hosseinszza/Sidex-release/Software/Test Board/fault.png

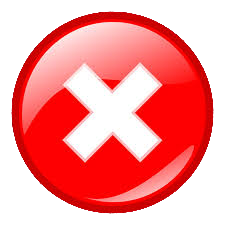
Software/Test Board/fault.png
