hosseinszza/Sidex-release/README.md

# Sidex-release
this files are release of last version
