hosseinszza/Sidex-release/Docs/PM.docx

مدیریت پروژه
چاپ و مونتاژ بردها
مدیریت سخت‌افزاری
پروگرام برد MBS
خدمات سخت‌افزاری پس از فروش
تعریف پروژه جدید در نرم‌افزار
تکمیل برد HBS و EBS
درخواست سیم‌کارت
تست و QC بردها
مدیریت سیم‌کشی پنل‌ها
تست پنل‌ها
خرید تجهیزات نصب
مدیریت نصب پروژه
ارتباط اینترنت بدون اتصال بررسی شود.
قرار دادن برد EBS در تابلو و تست نرم‌افزاری (فقط با اتصال LANها)
سیم‌کشی بردهای EBS در تابلو فرمان
بررسی کارایی EBS (بررسی سون‌سگمنت‌ها و احضارها در نرم‌افزار)
سیم‌کشی طبقات (پاور و LAN طبقات وصل نشود)
نصب پاور و LAN از بالاترین طبقه و بررسی ترتیبی با نرم‌افزار
انجام Learning آسانسور در حالت Noemal
سیم‌کشی شستی داخل کابین
قرار دادن آسانسورها در حالت Ready
تست تمامی پنل‌ها

مراحل راه‌اندازی پروژه
