hosseinszza/Sidex-release/PMF 1402-06-01.xlsx

Sheet: Hub Board
Component | Footprint | Required Amount
RJ45 FMR | RJ45 Female Right | 3
Phoenix 2MR 5.08 | phonix 2pin right 5.08 | 1

Sheet: Touch Board
Component | Footprint | Required Amount
Cap 1000uF(dip) | cap 03 | 1
Cap 100nF(1206) | SMD_CAP_1206 | 1
Cap 100uF(dip) | cap 03 | 1
Cap 10uF(Ctantal) | CAPMP6032X280N | 1
D SM5822 | 1N5822 smd - Size A (SMA) - smd code SS34 | 2
F 4A(1206) | Fuse SMD 1206 | 1
IC ADM485 | SO8_NARROW_N | 1
Ind 100uH(RH127) | BOURNS SRR1280 | 1
LAN Cable(5m) |  | 1
LED Red(603) | LED 0603/1608 RED | 3
Phoenix 2MR 5.08 | phonix 2pin right 5.08 | 1
Phoenix 8MR 3.81 | phonix 8pin right 3.81 | 1
Pin Header Female 20x2 | FEMALE 20x2 | 1
Pin Header Male 2x1 | Male 2X1 | 1
Power Jack | Power Jack | 1
Power Source 24V 2A |  | 1
Rasberry FAN |  | 1
Rasberry Pi4 2GB RAM |  | 1
Reg LM2576-5V | TO-263-5 | 1
Res 10K(603) | RES 0603 (1608X06L) | 2
Res 150R(1206) | RES 1206 (3216X08L) | 1
Res 1K(603) | RES 0603 (1608X06L) | 1
Res 560R(603) | RES 0603 (1608X06L) | 2
RJ45 FMR | RJ45 Female Right | 1
SD Card(16GB) |  | 1

Sheet: HBS V1.0
Component | Footprint | Required Amount
Cap 100nF(1206) | SMD_CAP_1206 | 2
Cap 100nF(603) | SMD_CAP_0603 | 1
Cap 100uF(dip) | cap 03 | 1
Cap 100uF(Ctantal) | CAPMP6032X280N | 3
Cap 10pF(603) | SMD_CAP_0603 | 2
Cap 10uF(603) | SMD_CAP_0603 | 24
Cap 10uF(Atantal) | CAPMP3216X180N | 1
Cap 1uF(603) | SMD_CAP_0603 | 1
Cap 20pF(603) | SMD_CAP_0603 | 2
Cap 2200uF(dip) | cap 03 | 1
Cap 330nF(1206) | 1206 | 1
D SM5822 | 1N5822 smd - Size A (SMA) - smd code SS34 | 3
D LL4148 | 1N4148 smd | 2
D SM712 | SOT23_BEC_M | 1
DZ 3.6V(Minimelf) | Minimelf | 10
DZ 30V(Minimelf) | Minimelf | 24
DZ 5.6V(Minimelf) | Minimelf | 1
DZ 9.1V(Minimelf) | Minimelf | 1
F 1A(1206) | Fuse SMD 1206 | 1
IC 74HC165 | SO-16 | 4
IC 74HC595 | SO-16 | 5
IC ADM485 | SO8_NARROW_N | 1
IC STM32F103C8T6 | LQFP-48 | 1
Ind 100uH(CD54) | CD45 SMD Inductor | 1
Ind 22uH(HPC6045) | HPC6045 or CD54 SMD INDUCTOR | 1
Jumper | Don't Forger Header 2x1 | 1
LAN Cable(5m) |  | 2
LED Red(1206) | LED SMD 1206 | 3
LED Red(603) | LED 0603/1608 RED | 42
Pair of Wires(10m) |  | 1
Phoenix 10MR 3.81 | phonix 10pin right 3.81 | 2
Phoenix 2MR 5.08 | phonix 2pin right 5.08 | 1
Phoenix 4MR 3.81 | phonix 4pin right 3.81 | 3
Phoenix 8MR 3.81 | phonix 8pin right 3.81 | 1
Pin Header Male Right 1x4 | Header 1x4 male rightangle | 1
Push Button | TE FSMSMTR | 1
Reg AMS1117-3.3 | SOT223 | 1
Reg L7805 | D2PAK-3 | 1
Reg LM2576-Adj | TO-263-5 | 1
Res 1.5K(603) | RES 0603 (1608X06L) | 1
Res 100K(1206) | RES 1206 (3216X08L) | 24
Res 10K(603) | RES 0603 (1608X06L) | 19
Res 10K(805) | RES 0805 (2012X06L) | 24
Res 150R(1206) | RES 1206 (3216X08L) | 1
Res 1K(1206) | RES 1206 (3216X08L) | 40
Res 1K(603) | RES 0603 (1608X06L) | 1
Res 1K(805) | RES 0805 (2012X06L) | 1
Res 20R(1206) | RES 1206 (3216X08L) | 40
Res 20R(603) | RES 0603 (1608X06L) | 4
Res 390R(603) | RES 0603 (1608X06L) | 1
Res 4.7K(805) | RES 0805 (2012X06L) | 1
Res 560R(603) | RES 0603 (1608X06L) | 3
Res 5K(1206) | RES 1206 (3216X08L) | 40
Res 5K(603) | RES 0603 (1608X06L) | 1
RFID RC522 Module |  | 1
RJ45 FMR | RJ45 Female Right | 1
SW DIP-2 | DIP Switch x2 | 1
SW DIP-6 | DIP Switch x6 | 1
Tr BSS138 | SOT23-3 | 24
Tr BC848 | SOT23-3 | 40
USB Micro | FCI USB 10118193-0001LF | 1
Var 07D471K | Varistor Short Hieght - Vertical | 2
XH 8FMR | Wired | 1
XH 8MR | CN_JST-B8B-S_XH | 1
XTAL 32.768KHz | XTAL RTC - Right | 1
XTAL 8MHz | Crystal SMD | 1
Print Board HBS V1.0 |  | 1
Assemble Board HBS V1.0 |  | 1

Sheet: HBS V2
Component | Footprint | Required Amount
Cap 100nF(1206) | SMD_CAP_1206 | 3
Cap 100nF(603) | SMD_CAP_0603 | 1
Cap 100uF(dip) | cap 03 | 1
Cap 100uF(Ctantal) | CAPMP6032X280N | 3
Cap 10pF(603) | SMD_CAP_0603 | 2
Cap 10uF(603) | SMD_CAP_0603 | 20
Cap 10uF(Atantal) | CAPMP3216X180N | 2
Cap 1uF(603) | SMD_CAP_0603 | 1
Cap 20pF(603) | SMD_CAP_0603 | 2
Cap 2200uF(dip) | cap 03 | 1
Cap 1nF(603) | SMD_CAP_0603 | 1
Cap 330nF(1206) | 1206 | 1
D SM5822 | 1N5822 smd - Size A (SMA) - smd code SS34 | 3
D LL4148 | 1N4148 smd | 22
D SM712 | SOT23_BEC_M | 2
DZ 3.6V(Minimelf) | Minimelf | 10
DZ 5.6V(Minimelf) | Minimelf | 1
DZ 9.1V(Minimelf) | Minimelf | 1
F 1A(1206) | Fuse SMD 1206 | 1
IC 74HC165 | SO-16 | 4
IC 74HC595 | SO-16 | 4
IC ADM485 | SO8_NARROW_N | 2
IC STM32F103C8T6 | LQFP-48 | 1
Ind 100uH(CD54) | CD45 SMD Inductor | 1
Ind 22uH(HPC6045) | HPC6045 or CD54 SMD INDUCTOR | 1
Jumper | Don't Forger Header 2x1 | 2
LAN Cable(5m) |  | 2
LED Red(1206) | LED SMD 1206 | 3
LED Red(603) | LED 0603/1608 RED | 26
Pair of Wires(10m) |  | 1
Phoenix 2MR 5.08 | phonix 2pin right 5.08 | 2
Phoenix 4MR 3.81 | phonix 4pin right 3.81 | 2
Phoenix 8MR 3.81 | phonix 8pin right 3.81 | 2
Pin Header Male Right 1x4 | Header 1x4 male rightangle | 1
Push Button | TE FSMSMTR | 1
Reg AMS1117-3.3 | SOT223 | 1
Reg L7805 | D2PAK-3 | 1
Reg LM2576-Adj | TO-263-5 | 1
Res 1.5K(603) | RES 0603 (1608X06L) | 1
Res 10K(603) | RES 0603 (1608X06L) | 24
Res 10K(805) | RES 0805 (2012X06L) | 20
Res 150R(1206) | RES 1206 (3216X08L) | 1
Res 1K(1206) | RES 1206 (3216X08L) | 24
Res 1K(603) | RES 0603 (1608X06L) | 1
Res 1K(805) | RES 0805 (2012X06L) | 1
Res 20R(1206) | RES 1206 (3216X08L) | 24
Res 20R(603) | RES 0603 (1608X06L) | 6
Res 390R(603) | RES 0603 (1608X06L) | 1
Res 4.7K(603) | RES 0603 (1608X06L) | 1
Res 4.7K(805) | RES 0805 (2012X06L) | 1
Res 560R(603) | RES 0603 (1608X06L) | 3
Res 5.6K(0805) | RES 0805 (2012X06L) | 1
Res 5K(1206) | RES 1206 (3216X08L) | 24
Res 5K(603) | RES 0603 (1608X06L) | 1
Res 100K(603) | RES 0603 (1608X06L) | 20
RFID RC522 Module |  | 1
RJ45 FMR | RJ45 Female Right | 2
SW DIP-2 | DIP Switch x2 | 1
SW DIP-6 | DIP Switch x6 | 1
Tr BSS138 | SOT23-3 | 20
Tr BC848 | SOT23-3 | 24
USB Micro | FCI USB 10118193-0001LF | 1
Var 07D471K | Varistor Short Hieght - Vertical | 2
XH 8FMR | Wired | 1
XH 8MR | CN_JST-B8B-S_XH | 1
XH 5FMR | Wired | 1
XH 5MR | CN_JST-B5B-S_XH | 1
XTAL 32.768KHz | XTAL RTC - Right | 1
XTAL 8MHz | Crystal SMD | 1
Print Board HBS V2.0 |  | 1
Assemble Board HBS V2.0 |  | 1

Sheet: HBS Screen
Component | Footprint | Required Amount
Cap 100nF(1206) | SMD_CAP_1206 | 3
Cap 100nF(603) | SMD_CAP_0603 | 1
Cap 100uF(dip) | cap 03 | 1
Cap 100uF(Ctantal) | CAPMP6032X280N | 3
Cap 10pF(603) | SMD_CAP_0603 | 2
Cap 10uF(603) | SMD_CAP_0603 | 20
Cap 10uF(Atantal) | CAPMP3216X180N | 2
Cap 1uF(603) | SMD_CAP_0603 | 1
Cap 20pF(603) | SMD_CAP_0603 | 2
Cap 2200uF(dip) | cap 03 | 1
Cap 1nF(603) | SMD_CAP_0603 | 1
Cap 330nF(1206) | 1206 | 1
D SM5822 | 1N5822 smd - Size A (SMA) - smd code SS34 | 3
D LL4148 | 1N4148 smd | 22
D SM712 | SOT23_BEC_M | 2
DZ 3.6V(Minimelf) | Minimelf | 10
DZ 5.6V(Minimelf) | Minimelf | 1
DZ 9.1V(Minimelf) | Minimelf | 1
F 1A(1206) | Fuse SMD 1206 | 1
IC 74HC165 | SO-16 | 4
IC 74HC595 | SO-16 | 4
IC ADM485 | SO8_NARROW_N | 2
IC STM32F103C8T6 | LQFP-48 | 1
Ind 100uH(CD54) | CD45 SMD Inductor | 1
Ind 22uH(HPC6045) | HPC6045 or CD54 SMD INDUCTOR | 1
Jumper | Don't Forger Header 2x1 | 2
LAN Cable(5m) |  | 2
LED Red(1206) | LED SMD 1206 | 3
LED Red(603) | LED 0603/1608 RED | 26
Pair of Wires(10m) |  | 1
Phoenix 2MR 5.08 | phonix 2pin right 5.08 | 2
Phoenix 4MR 3.81 | phonix 4pin right 3.81 | 2
Phoenix 8MR 3.81 | phonix 8pin right 3.81 | 2
Pin Header Male Right 1x4 | Header 1x4 male rightangle | 1
Push Button | TE FSMSMTR | 1
Reg AMS1117-3.3 | SOT223 | 1
Reg L7805 | D2PAK-3 | 1
Reg LM2576-Adj | TO-263-5 | 1
Res 1.5K(603) | RES 0603 (1608X06L) | 1
Res 10K(603) | RES 0603 (1608X06L) | 24
Res 10K(805) | RES 0805 (2012X06L) | 20
Res 150R(1206) | RES 1206 (3216X08L) | 1
Res 1K(1206) | RES 1206 (3216X08L) | 24
Res 1K(603) | RES 0603 (1608X06L) | 1
Res 1K(805) | RES 0805 (2012X06L) | 1
Res 20R(1206) | RES 1206 (3216X08L) | 24
Res 20R(603) | RES 0603 (1608X06L) | 6
Res 390R(603) | RES 0603 (1608X06L) | 1
Res 4.7K(603) | RES 0603 (1608X06L) | 1
Res 4.7K(805) | RES 0805 (2012X06L) | 1
Res 560R(603) | RES 0603 (1608X06L) | 3
Res 5.6K(0805) | RES 0805 (2012X06L) | 1
Res 5K(1206) | RES 1206 (3216X08L) | 24
Res 5K(603) | RES 0603 (1608X06L) | 1
Res 100K(603) | RES 0603 (1608X06L) | 20
RFID RC522 Module |  | 1
RJ45 FMR | RJ45 Female Right | 2
SW DIP-2 | DIP Switch x2 | 1
SW DIP-6 | DIP Switch x6 | 1
Tr BSS138 | SOT23-3 | 20
Tr BC848 | SOT23-3 | 24
USB Micro | FCI USB 10118193-0001LF | 1
Var 07D471K | Varistor Short Hieght - Vertical | 2
XH 8FMR | Wired | 1
XH 8MR | CN_JST-B8B-S_XH | 1
XH 5FMR | Wired | 1
XH 5MR | CN_JST-B5B-S_XH | 1
XTAL 32.768KHz | XTAL RTC - Right | 1
XTAL 8MHz | Crystal SMD | 1

Sheet: EBS V1.0
Component | Footprint | Required Amount
Cap 100nF(1206) | 1206 | 2
Cap 100nF(603) | SMD_CAP_0603 | 1
Cap 100uF(Ctantal) | CAPMP6032X280N | 2
Cap 10pF(603) | SMD_CAP_0603 | 1
Cap 10uF(603) | SMD_CAP_0603 | 24
Cap 10uF(Atantal) | CAPMP3216X180N | 1
Cap 1uF(603) | SMD_CAP_0603 | 19
Cap 20pF(603) | SMD_CAP_0603 | 2
Cap 330nF(1206) | 1206 | 1
D SM5822 | 1N5822 smd - Size A (SMA) - smd code SS34 | 2
D LL4148 | 1N4148 smd | 27
D SM712 | SOT23_BEC_M | 1
DZ 3.6V(Minimelf) | Minimelf | 4
DZ 5.6V(Minimelf) | Minimelf | 1
DZ 9.1V(Minimelf) | Minimelf | 1
F 1A(1206) | Fuse SMD 1206 | 2
FB BLM21PG | R 0805 / 2012 | 1
IC 74HC165 | SO-16 | 5
IC 74HC595 | SO-16 | 3
IC ADM485 | SO8_NARROW_N | 1
IC STM32F103C8T6 | LQFP-48 | 1
IC ULN2003 | SO-16 | 1
LAN Cable(5m) |  | 1
LED Green(1206) | LED SMD 1206 | 1
LED Red(1206) | LED SMD 1206 | 3
LED Red(603) | LED 0603/1608 RED | 42
Opto PC814 | PS2501-1 | 1
Opto TLP521 | PS2501-1 | 16
Phoenix 10MR 3.81 | phonix 10pin right 3.81 | 2
Phoenix 2MR 5.08 | phonix 2pin right 5.08 | 1
Phoenix 4MR 3.81 | phonix 4pin right 3.81 | 1
Phoenix 8MR 3.81 | phonix 8pin right 3.81 | 2
Pin Header Male Right 1x4 | Header 1x4 male rightangle | 1
Push Button | TE FSMSMTR | 1
Reg AMS1117-3.3 | SOT223 | 1
Reg L7805 | D2PAK-3 | 1
Relay 5V 7A | Relay 20x16x20 HJR | 1
Res 1.5K(603) | RES 0603 (1608X06L) | 1
Res 100K(603) | RES 0603 (1608X06L) | 24
Res 10K(603) | RES 0603 (1608X06L) | 14
Res 10K(805) | RES 0805 (2012X06L) | 24
Res 150R(1206) | RES 1206 (3216X08L) | 1
Res 180K(1206) | RES 1206 (3216X08L) | 1
Res 1K(1206) | RES 1206 (3216X08L) | 24
Res 1K(603) | RES 0603 (1608X06L) | 1
Res 3.6K(1206) | RES 1206 (3216X08L) | 16
Res 20K(603) | RES 0603 (1608X06L) | 17
Res 20R(603) | RES 0603 (1608X06L) | 4
Res 390R(603) | RES 0603 (1608X06L) | 1
Res 560R(603) | RES 0603 (1608X06L) | 4
Res 5K(1206) | RES 1206 (3216X08L) | 16
Res 5K(603) | RES 0603 (1608X06L) | 25
RJ45 FMR | RJ45 Female Right | 1
SW DIP-4 | DIP Switch x4 | 1
Tr BSS138 | SOT23-3 | 24
Tr BC848 | SOT23-3 | 24
USB Micro | FCI USB 10118193-0001LF | 1
Var 07D471K | Varistor Short Hieght - Vertical | 2
XH 4FMR | Wired | 1
XH 4MR | CN_JST-B4B-S_XH | 1
XTAL 32.768KHz | XTAL RTC - Right | 1
XTAL 8MHz | Crystal SMD | 1
Print Board EBS V1.0 |  | 1
Assemble Board EBS V1.0 |  | 1

Sheet: EBS V2
Component | Footprint | Required Amount
Cap 100uF(dip) | cap 03 | 2
Cap 2200uF(dip) | cap 03 | 1
Cap 1000uF(dip) | cap 03 | 1
Cap 100nF(1206) | 1206 | 3
Cap 100nF(603) | SMD_CAP_0603 | 1
Cap 100uF(Ctantal) | CAPMP6032X280N | 3
Cap 10pF(603) | SMD_CAP_0603 | 1
Cap 10uF(Atantal) | CAPMP3216X180N | 2
Cap 1uF(603) | SMD_CAP_0603 | 15
Cap 20pF(603) | SMD_CAP_0603 | 2
Cap 1nF(603) | SMD_CAP_0603 | 1
Cap 330nF(1206) | 1206 | 1
D SM5822 | 1N5822 smd - Size A (SMA) - smd code SS34 | 3
D LL4148 | 1N4148 smd | 3
D SM712 | SOT23_BEC_M | 2
DZ 3.6V(Minimelf) | Minimelf | 4
DZ 5.6V(Minimelf) | Minimelf | 1
DZ 9.1V(Minimelf) | Minimelf | 1
DZ 13V(Minimelf) | Minimelf | 1
F 1A(1206) | Fuse SMD 1206 | 3
FB BLM21PG | R 0805 / 2012 | 1
Jumper | Don't Forger Header 2x1 | 3
IC 74HC165 | SO-16 | 2
IC ADM485 | SO8_NARROW_N | 2
IC STM32F103C8T6 | LQFP-48 | 1
IC ULN2003 | SO-16 | 1
Ind 100uH(CD54) | CD45 SMD Inductor | 2
Ind 22uH(HPC6045) | HPC6045 or CD54 SMD INDUCTOR | 1
LAN Cable(5m) |  | 1
LED Green(1206) | LED SMD 1206 | 1
LED Red(1206) | LED SMD 1206 | 3
LED Red(603) | LED 0603/1608 RED | 14
Opto PC814 | PS2501-1 | 1
Opto TLP521 | PS2501-1 | 12
Phoenix 2MR 5.08 | phonix 2pin right 5.08 | 1
Phoenix 4MR 3.81 | phonix 4pin right 3.81 | 2
Phoenix 8MR 3.81 | phonix 8pin right 3.81 | 1
Pin Header Male Right 1x4 | Header 1x4 male rightangle | 1
Push Button | TE FSMSMTR | 1
Reg AMS1117-3.3 | SOT223 | 1
Reg L7805 | D2PAK-3 | 1
Reg LM2576-Adj | TO-263-5 | 1
Reg LM2576-12V | TO-263-5 | 1
Relay 5V 7A | Relay 20x16x20 HJR | 1
Res 1.5K(603) | RES 0603 (1608X06L) | 1
Res 10K(603) | RES 0603 (1608X06L) | 19
Res 150R(1206) | RES 1206 (3216X08L) | 2
Res 180K(1206) | RES 1206 (3216X08L) | 1
Res 1K(603) | RES 0603 (1608X06L) | 1
Res 3.6K(1206) | RES 1206 (3216X08L) | 12
Res 20K(603) | RES 0603 (1608X06L) | 13
Res 20R(603) | RES 0603 (1608X06L) | 6
Res 390R(603) | RES 0603 (1608X06L) | 1
Res 560R(603) | RES 0603 (1608X06L) | 4
Res 5K(1206) | RES 1206 (3216X08L) | 12
Res 5K(603) | RES 0603 (1608X06L) | 1
Res 47K(603) | RES 0603 (1608X06L) | 1
Res 4.7K(805) |  | 1
Res 1K(805) |  | 1
RJ45 FMR | RJ45 Female Right | 2
SW DIP-4 | DIP Switch x4 | 1
USB Micro | FCI USB 10118193-0001LF | 1
Var 07D471K | Varistor Short Hieght - Vertical | 4
XH 4FMR | Wired | 1
XH 4MR | CN_JST-B4B-S_XH | 1
XTAL 32.768KHz | XTAL RTC - Right | 1
XTAL 8MHz | Crystal SMD | 1
Print Board EBS V2.0 |  | 1
Assemble Board EBS V2.0 |  | 1

Sheet: EBS V3
Component | Footprint | Required Amount
Cap 100uF(dip) | cap 03 | 1
Cap 2200uF(dip) | cap 03 | 1
Cap 100nF(1206) | 1206 | 26
Cap 100nF(603) | SMD_CAP_0603 | 24
Cap 100uF(Ctantal) | CAPMP6032X280N | 3
Cap 10pF(603) | SMD_CAP_0603 | 1
Cap 10uF(603) | SMD_CAP_0603 | 24
Cap 10uF(Atantal) | CAPMP3216X180N | 1
Cap 1uF(603) | SMD_CAP_0603 | 14
Cap 20pF(603) | SMD_CAP_0603 | 2
Cap 1nF(603) | SMD_CAP_0603 | 1
Cap 330nF(603) | SMD_CAP_603 | 12
Cap 330nF(1206) | 1206 | 25
D SM5822 | 1N5822 smd - Size A (SMA) - smd code SS34 | 2
D LL4148 | 1N4148 smd | 3
D SM712 | SOT23_BEC_M | 3
DZ 3.6V(Minimelf) | Minimelf | 1
DZ 5.6V(Minimelf) | Minimelf | 1
DZ 9.1V(Minimelf) | Minimelf | 1
DZ 13V(Minimelf) | Minimelf | 1
F 1A(1206) | Fuse SMD 1206 | 3
Jumper | Don't Forger Header 2x1 | 3
IC 74HC595 | SO-16 | 3
IC 74HC165 | SO-16 | 5
IC ADM485 | SO8_NARROW_N | 1
IC STM32F103C8T6 | LQFP-48 | 1
Ind 100uH(CD54) | CD45 SMD Inductor | 2
Ind 22uH(HPC6045) | HPC6045 or CD54 SMD INDUCTOR | 1
Ind 2.2uH(1210) |  | 1
LAN Cable(5m) |  | 1
LED Green(1206) | LED SMD 1206 | 1
LED Red(1206) | LED SMD 1206 | 3
LED Red(603) | LED 0603/1608 RED | 38
Opto PC814 | PS2501-1 | 1
Opto TLP521 | PS2501-1 | 12
Phoenix 10MR 3.81 | phonix 10pin right 3.81 | 2
Phoenix 2MR 5.08 | phonix 2pin right 5.08 | 1
Phoenix 4MR 3.81 | phonix 4pin right 3.81 | 2
Phoenix 8MR 3.81 | phonix 8pin right 3.81 | 1
Pin Header Male Right 1x4 | Header 1x4 male rightangle | 1
Push Button | TE FSMSMTR | 1
Reg AMS1117-3.3 | SOT223 | 1
Reg L7805 | D2PAK-3 | 1
Reg LM2576-Adj | TO-263-5 | 1
Reg LM2576-12V | TO-263-5 | 1
Relay 5V 7A | Relay 20x16x20 HJR | 1
Res 1.5K(603) | RES 0603 (1608X06L) | 1
Res 10K(603) | RES 0603 (1608X06L) | 38
Res 150R(1206) | RES 1206 (3216X08L) | 2
Res 180K(1206) | RES 1206 (3216X08L) | 1
Res 1K(603) | RES 0603 (1608X06L) | 25
Res 1K(805) | RES 0805 (2012X06L) | 1
Res 20K(603) | RES 0603 (1608X06L) | 13
Res 20R(1206) | RES 1206 (3216X08L) | 2
Res 20R(603) | RES 0603 (1608X06L) | 2
Res 390R(603) | RES 0603 (1608X06L) | 1
Res 560R(603) | RES 0603 (1608X06L) | 4
Res 5K(1206) | RES 1206 (3216X08L) | 48
Res 5K(603) | RES 0603 (1608X06L) | 24
Res 47K(603) | RES 0603 (1608X06L) | 1
Res 4.7K(805) |  | 1
Res 1K(805) |  | 1
RJ45 FMR | RJ45 Female Right | 2
Tr BC848 | SOT23-3 | 1
SW DIP-4 | DIP Switch x4 | 1
USB Micro | FCI USB 10118193-0001LF | 1
Var 07D471K | Varistor Short Hieght - Vertical | 4
XH 4FMR | Wired | 1
XH 4MR | CN_JST-B4B-S_XH | 1
XTAL 32.768KHz | XTAL RTC - Right | 1
XTAL 8MHz | Crystal SMD | 1
Print Board EBS V3.0 |  | 1
Assemble Board EBS V3.0 |  | 1

Sheet: MBS V1.0
Component | Footprint | Required Amount
Cap 2200uF(dip) | cap 03 | 1
Cap 100nF(1206) | 1206 | 6
Cap 100nF(603) | SMD_CAP_0603 | 2
Cap 100uF(dip) | cap 03 | 1
Cap 100uF(Ctantal) | CAPMP6032X280N | 3
Cap 10uF(Atantal) | CAPMP3216X180N | 3
Cap 10pF(603) | SMD_CAP_0603 | 2
Cap 1uF(603) | SMD_CAP_0603 | 1
Cap 22pF(603) | SMD_CAP_0603 | 2
Cap 330nF(1206) | 1206 | 1
D SM5822 | 1N5822 smd - Size A (SMA) - smd code SS34 | 2
D LL4148 | 1N4148 smd | 2
D SM712 | SOT23_BEC_M | 3
DZ 3.6V(Minimelf) | Minimelf | 3
DZ 5.6V(Minimelf) | Minimelf | 2
DZ 9.1V(Minimelf) | Minimelf | 1
F 1A(1206) | Fuse SMD 1206 | 1
F 2A(1206) | Fuse SMD 1206 | 1
IC ADM485 | SO8_NARROW_N | 3
IC STM32F103RET6 | LQFP-64 | 1
Ind 100uH(RH127) | BOURNS SRR1280 | 1
Ind 22uH(HPC6045) | HPC6045 or CD54 SMD INDUCTOR | 1
LAN Cable(5m) |  | 2
LED Green(1206) | LED SMD 1206 | 1
LED Red(1206) | LED SMD 1206 | 3
Phoenix 2MR 5.08 | phonix 2pin right 5.08 | 1
Pin Header Male 1x6 19mm | HEADER 6X1 | 1
Pin Header Male Right 1x4 | Header 1x4 male rightangle | 1
Power Jack | Power Jack | 1
Power Source 24V 2A |  | 1
Push Button | TE FSMSMTR | 1
Reg AMS1117-3.3 | SOT223 | 1
Reg L7805 | D2PAK-3 | 1
Reg LM2576-Adj | TO-263-5 | 1
Res 1.5K(603) | RES 0603 (1608X06L) | 1
Res 1K(805) | RES 0805 (2012X06L) | 1
Res 10K(603) | RES 0603 (1608X06L) | 20
Res 1K(603) | RES 0603 (1608X06L) | 1
Res 20R(603) | RES 0603 (1608X06L) | 8
Res 2K(603) | RES 0603 (1608X06L) | 1
Res 390R(603) | RES 0603 (1608X06L) | 1
Res 4.7K(805) | RES 0805 (2012X06L) | 1
Res 560R(603) | RES 0603 (1608X06L) | 1
Res 5K(603) | RES 0603 (1608X06L) | 1
RJ45 FMR | RJ45 Female Right | 2
USB Micro | FCI USB 10118193-0001LF | 1
Var 07D471K | or 07D431K or 07D391K | 4
XTAL 32.768KHz | XTAL RTC - Right | 1
XTAL 8MHz | Crystal SMD | 1
Print Board MBS V1.0 |  | 1
Assemble Board MBS V1.0 |  | 1

Sheet: MOBS V1.0
Component | Footprint | Required Amount
Cap 1000uF(dip) | cap 03 | 1
Cap 100nF(1206) | SMD_CAP_1206 | 2
Cap 100nF(603) | SMD_CAP_0603 | 1
Cap 100uF(dip) | cap 03 | 1
Cap 100uF(Ctantal) | CAPMP6032X280N | 1
Cap 10pF(603) | SMD_CAP_0603 | 3
Cap 10uF(Ctantal) | CAPMP6032X280N | 1
Cap 1uF(603) | SMD_CAP_0603 | 1
Cap 20pF(603) | SMD_CAP_0603 | 2
Cap 33pF(603) | SMD_CAP_0603 | 4
D SM5822 | 1N5822 smd - Size A (SMA) - smd code SS34 | 1
DZ 5.1V(dip) | DO-35 | 1
DZ 6.8V(Minimelf) | Minimelf | 4
F 4A(1206) | Fuse SMD 1206 | 1
FB BLM21PG | R 0805 / 2012 | 1
IC ADM485 | SO8_NARROW_N | 1
IC STM32F103C8T6 | LQFP-48 | 1
Ind 100uH(RH127) | BOURNS SRR1280 | 1
Jumper | Jumper Small - 2.54 - GRAY | 1
LED Green(1206) | LED SMD 1206 | 3
LED Red(1206) | LED SMD 1206 | 3
Pin Header Female 1x6 | Female 6x1 | 1
Pin Header Male Right 1x4 | Header 1x4 male rightangle | 1
Push Button | TE FSMSMTR | 1
Quectel UC15 | Quectel UC15 | 1
Reg LM2576-Adj | TO-263-5 | 1
Res 1.5K(603) | RES 0603 (1608X06L) | 1
Res 1.5K(805) | RES 0805 (2012X06L) | 1
Res 10K(1206) | RES 1206 (3216X08L) | 1
Res 10K(603) | RES 0603 (1608X06L) | 11
Res 15K(1206) | RES 1206 (3216X08L) | 1
Res 1K(603) | RES 0603 (1608X06L) | 1
Res 20R(603) | RES 0603 (1608X06L) | 5
Res 3.6K(805) | RES 0805 (2012X06L) | 1
Res 390R(603) | RES 0603 (1608X06L) | 1
Res 4.7K(603) | RES 0603 (1608X06L) | 4
Res 470R(603) | RES 0603 (1608X06L) | 1
Res 47K(603) | RES 0603 (1608X06L) | 4
Res 560R(603) | RES 0603 (1608X06L) | 2
Res 680R(603) | RES 0603 (1608X06L) | 2
SMA Antena |  | 1
SMA FMR | MOLEX SD-73100-0114 | 1
Socket_SIM_MEM | microsd&SimCardSocket | 1
SW DPDT | Switch - SPDT 15.5 | 1
Tr BC848 | SOT23-3 | 4
Tr BSS138 | SOT23-3 | 2
USB Micro | FCI USB 10118193-0001LF | 1
XTAL 32.768KHz | XTAL RTC - Right | 1
XTAL 8MHz | Crystal SMD | 1
Print Board MOBS V1.0 |  | 1
Assemble Board MOBS V1.0 |  | 1

Sheet: Components
Component | Footprint | HBS V1.0 | HBS V2.0 | EBS V1.0 | EBS V3.0 | MBS V1.0 | MOBS V1.0 | 1->2 | All Requ. | Unit Price (Rial) | Total Price (Rial) | Store | Inventory | bought
Cap 1000uF(dip) | cap 03 | 0 | 0 | 0 | 0 | 0 | 0 | 0 | 0 | 22500 | 0 | javan (http://www.javanelec.com/Shops/ProductDetail/148?part_number=1000UF%2F25V) | 0 | 0
Cap 100nF(1206) | SMD_CAP_1206 | 0 | 0 | 2 | 0 | 0 | 0 | 0 | 2 | 2700 | 5400 | javan (https://www.javanelec.com/Shops/ProductDetail/7589) | 146 | -144
Cap 100nF(603) | SMD_CAP_0603 | 0 | 0 | 1 | 0 | 0 | 0 | 0 | 1 | 1240 | 1240 | javan (https://www.javanelec.com/Shops/ProductDetail/41619) | 110 | -109
Cap 100uF(dip) | cap 03 | 0 | 0 | 0 | 0 | 0 | 0 | 0 | 0 | 7190 | 0 | javan (https://www.javanelec.com/Shops/ProductDetail/157?part_number=100UF%2F35V) | 16 | -16
Cap 100uF(Ctantal) | CAPMP6032X280N | 0 | 0 | 2 | 0 | 0 | 0 | 0 | 2 | 84700 | 169400 | javan (https://www.javanelec.com/Shops/ProductDetail/4333) | 28 | -26
Cap 10pF(603) | SMD_CAP_0603 | 0 | 0 | 1 | 0 | 0 | 0 | 0 | 1 | 940 | 940 | javan (https://www.javanelec.com/Shops/ProductDetail/9290) | 28 | -27
Cap 10uF(603) | SMD_CAP_0603 | 0 | 0 | 24 | 0 | 0 | 0 | 0 | 24 | 2616 | 62784 | ickala (https://www.ickala.com/cap-smd-0603/17293-c10uf50vs0603.html) | 0 | 24
Cap 10uF(Atantal) | CAPMP3216X180N | 0 | 0 | 1 | 0 | 0 | 0 | 0 | 1 | 30400 | 30400 | javan (https://www.javanelec.com/Shops/ProductDetail/7655) | 0 | 1
Cap 10uF(Ctantal) | CAPMP6032X280N | 0 | 0 | 0 | 0 | 0 | 0 | 0 | 0 | 58000 | 0 | javan (https://www.javanelec.com/Shops/ProductDetail/7657) | 0 | 0
Cap 1nF(603) | SMD_CAP_0603 | 0 | 0 | 0 | 0 | 0 | 0 | 0 | 0 | 790 | 0 | javan (https://www.javanelec.com/Shops/ProductDetail/4932) |  | 0
Cap 1uF(603) | SMD_CAP_0603 | 0 | 0 | 19 | 0 | 0 | 0 | 0 | 19 | 1580 | 30020 | javan (https://www.javanelec.com/Shops/ProductDetail/21012) | 68 | -49
Cap 20pF(603) | SMD_CAP_0603 | 0 | 0 | 2 | 0 | 0 | 0 | 0 | 2 | 1060 | 2120 | javan (http://www.javanelec.com/Shops/ProductDetail/39195?part_number=20PF%20%280603%29%2050V%205%25%20COG) | 28 | -26
Cap 2200uF(dip) | cap 03 | 0 | 0 | 0 | 0 | 0 | 0 | 0 | 0 | 21900 | 0 | javan (https://www.javanelec.com/Shops/ProductDetail/45992?part_number=2200UF%2F10V-10X20-105C-GREEN) | 0 | 0
Cap 22pF(603) | SMD_CAP_0603 | 0 | 0 | 0 | 0 | 0 | 0 | 0 | 0 | 1000 | 0 | javan (https://www.javanelec.com/Shops/ProductDetail/4168) | 4 | -4
Cap 330nF(603) | SMD_CAP_603 | 0 | 0 | 0 | 0 | 0 | 0 | 0 | 0 | 1890 | 0 | javan (https://www.javanelec.com/Shops/ProductDetail/7621) | 0 | 0
Cap 330nF(1206) | SMD_CAP_1206 | 0 | 0 | 1 | 0 | 0 | 0 | 0 | 1 | 5650 | 5650 | javan (http://www.javanelec.com/Shops/ProductDetail/7621?part_number=330NF%20%281206%29%2050V%2010%25%20X7R) | 0 | 1
Cap 33pF(603) | SMD_CAP_0603 | 0 | 0 | 0 | 0 | 0 | 0 | 0 | 0 | 984 | 0 | javan (http://www.javanelec.com/Shops/ProductDetail/30112?part_number=33PF%20%280603%29%2050V%205%25%20COG) | 0 | 0
D SM5822 | 1N5822 smd - Size A (SMA) - smd code SS34 | 0 | 0 | 2 | 0 | 0 | 0 | 0 | 2 | 4490 | 8980 | javan (https://www.javanelec.com/Shops/ProductDetail/3440) | 25 | -23
D LL4148 | 1N4148 smd | 0 | 0 | 27 | 0 | 0 | 0 | 0 | 27 | 2020 | 54540 | javan (https://www.javanelec.com/Shops/ProductDetail/7730) | 60 | -33
D SM712 | SOT23_BEC_M | 0 | 0 | 1 | 0 | 0 | 0 | 0 | 1 | 110000 | 110000 | javan (https://www.javanelec.com/Shops/ProductDetail/3780) | 0 | 1
DZ 3.6V(Minimelf) | Minimelf | 0 | 0 | 4 | 0 | 0 | 0 | 0 | 4 | 4220 | 16880 | javan (https://www.javanelec.com/Shops/ProductDetail/5564) | 0 | 4
DZ 30V(Minimelf) | Minimelf | 0 | 0 | 0 | 0 | 0 | 0 | 0 | 0 | 2690 | 0 | javan (https://www.javanelec.com/Shops/ProductDetail/10684) |  | 0
DZ 5.1V(dip) | DO-35 | 0 | 0 | 0 | 0 | 0 | 0 | 0 | 0 | 4760 | 0 | javan (http://www.javanelec.com/Shops/ProductDetail/11455?part_number=ZENER%205.1V-1W) | 0 | 0
DZ 5.6V(Minimelf) | Minimelf | 0 | 0 | 1 | 0 | 0 | 0 | 0 | 1 | 4220 | 4220 | javan (https://www.javanelec.com/Shops/ProductDetail/7724) | 18 | -17
DZ 6.8V(Minimelf) | Minimelf | 0 | 0 | 0 | 0 | 0 | 0 | 0 | 0 | 4220 | 0 | javan (http://www.javanelec.com/Shops/ProductDetail/16656?part_number=ZENER%206.8V-MINI%20MELF) | 0 | 0
DZ 9.1V(Minimelf) | Minimelf | 0 | 0 | 1 | 0 | 0 | 0 | 0 | 1 | 4220 | 4220 | javan (https://www.javanelec.com/Shops/ProductDetail/7727) | 16 | -15
DZ 13V(Minimelf) | Minimelf | 0 | 0 | 0 | 0 | 0 | 0 | 0 | 0 | 2730 | 0 | javan (https://www.javanelec.com/Shops/ProductDetail/2365) |  | 0
F 1A(1206) | Fuse SMD 1206 | 0 | 0 | 2 | 0 | 0 | 0 | 0 | 2 | 10100 | 20200 | javan (https://www.javanelec.com/Shops/ProductDetail/46054?part_number=FAST%20FUSE%201A%2072V%20%281206%29) | 24 | -22
F 2A(1206) | Fuse SMD 1206 | 0 | 0 | 0 | 0 | 0 | 0 | 0 | 0 | 10100 | 0 | javan (https://www.javanelec.com/Shops/ProductDetail/46057?part_number=FAST%20FUSE%202A%2072V%20%281206%29) | 2 | -2
FB BLM21PG | R 0805 / 2012 | 0 | 0 | 1 | 0 | 0 | 0 | 0 | 1 | 1700 | 1700 | javan (https://www.javanelec.com/Shops/ProductDetail/11901) | 0 | 1
IC 74HC165 | SO-16 | 0 | 0 | 5 | 0 | 0 | 0 | 0 | 5 | 53100 | 265500 | javan (https://www.javanelec.com/Shops/ProductDetail/25374) | 0 | 5
IC 74HC595 | SO-16 | 0 | 0 | 3 | 0 | 0 | 0 | 0 | 3 | 45780 | 137340 | ickala (https://ickala.com/register-and-shift-register-ic/2666-74hc595d.html) | 20 | -17
IC ADM485 | SO8_NARROW_N | 0 | 0 | 1 | 0 | 0 | 0 | 0 | 1 | 187000 | 187000 | javan (https://www.javanelec.com/Shops/ProductDetail/18873) | 0 | 1
IC STM32F103C8T6 | LQFP-48 - or CBT6 | 0 | 0 | 1 | 0 | 0 | 0 | 0 | 1 | 592000 | 592000 | javan (https://www.javanelec.com/Shops/ProductDetail/8649?part_number=STM32F103C8T6) | 0 | 1
IC STM32F103RET6 | LQFP-64 | 0 | 0 | 0 | 0 | 0 | 0 | 0 | 0 | 1411000 | 0 | javan (https://www.javanelec.com/Shops/ProductDetail/11232) | 0 | 0
IC ULN2003 | SO-16 | 0 | 0 | 1 | 0 | 0 | 0 | 0 | 1 | 44100 | 44100 | javan (https://www.javanelec.com/Shops/ProductDetail/19550) | 0 | 1
Ind 100uH(CD54) | CD45 SMD Inductor | 0 | 0 | 0 | 0 | 0 | 0 | 0 | 0 | 8830 | 0 | javan (https://www.javanelec.com/Shops/ProductDetail/24419) |  | 0
Ind 100uH(CD54) | CD45 SMD Inductor | 0 | 0 | 0 | 0 | 0 | 0 | 0 | 0 | 12300 | 0 | javan (http://www.javanelec.com/Shops/ProductDetail/13750?part_number=RH127-100UH%20SMD) | 18 | -18
Ind 100uH(RH127) | BOURNS SRR1280 | 0 | 0 | 0 | 0 | 0 | 0 | 0 | 0 | 68500 | 0 | javan (http://www.javanelec.com/Shops/ProductDetail/13750?part_number=RH127-100UH%20SMD) | 2 | -2
Ind 22uH(HPC6045) | HPC6045 or CD54 SMD INDUCTOR | 0 | 0 | 0 | 0 | 0 | 0 | 0 | 0 | 12200 | 0 | javan (https://www.javanelec.com/Shops/ProductDetail/12977) | 16 | -16
Ind 2.2uH(1210) |  | 0 | 0 | 0 | 0 | 0 | 0 | 0 | 0 | 12200 | 0 | javan (https://www.javanelec.com/Shops/ProductDetail/12977) | 4 | -4
Jumper | Jumper - 2.54 - And it's 2x1 Header | 0 | 0 | 0 | 0 | 0 | 0 | 0 | 0 | 3706 | 0 | ickala (https://www.ickala.com/pinheader-parts/26296-jumper2pin-%D8%B3%D8%A8%D8%B2.html) | 32 | -32
LAN Cable(5m) |  | 0 | 0 | 1 | 0 | 0 | 0 | 0 | 1 | 900000 | 900000 | cable (https://s16.picofile.com/file/8426105568/Lan_Cable.jpg) | 28 | -27
LED Green(1206) | LED SMD 1206 | 0 | 0 | 1 | 0 | 0 | 0 | 0 | 1 | 1770 | 1770 | javan (http://www.javanelec.com/Shops/ProductDetail/11929?part_number=LED%20%281206%29%20G) | 6 | -5
LED Red(1206) | LED SMD 1206 | 0 | 0 | 3 | 0 | 0 | 0 | 0 | 3 | 1720 | 5160 | javan (https://www.javanelec.com/Shops/ProductDetail/11930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) | 48 | -45
LED Red(603) | LED 0603/1608 RED | 0 | 0 | 42 | 0 | 0 | 0 | 0 | 42 | 916 | 38472 | javan (https://www.javanelec.com/Shops/ProductDetail/28905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) | 0 | 42
Opto PC814 | PS2501-1 | 0 | 0 | 1 | 0 | 0 | 0 | 0 | 1 | 58244 | 58244 | lion (https://lionelectronic.ir/products/538-PC814) | 4 | -3
Opto TLP521 | PS2501-1 | 0 | 0 | 16 | 0 | 0 | 0 | 0 | 16 | 30900 | 494400 | javan (https://www.javanelec.com/Shops/ProductDetail/37542) | 48 | -32
Pair of Wires(10m) | سیم برق افشان 2 در 0/5 | 0 | 0 | 0 | 0 | 0 | 0 | 0 | 0 | 500000 | 0 | digikala (https://www.digikala.com/product/dkp-2161098/%D8%B3%DB%8C%D9%85-%D8%A8%D8%B1%D9%82-%D8%A7%D9%81%D8%B4%D8%A7%D9%86-2-%D8%AF%D8%B1-05-%D9%85%D8%AF%D9%84-pn-1001) |  | 0
Phoenix 10MR 3.81 | phonix 10pin right 3.81 | 0 | 0 | 2 | 0 | 0 | 0 | 0 | 2 | 563530 | 1127060 | ickala (https://www.ickala.com/phonix-381-right/20710-phoenix-10pin-right-381mm.html) | 0 | 2
Phoenix 2MR 5.08 | phonix 2pin right 5.08 | 0 | 0 | 1 | 0 | 0 | 0 | 25 | 26 | 40200 | 1045200 | javan (http://www.javanelec.com/Shops/ProductDetail/1970?part_number=PHOENIX%202%20PIN%20RA) | 0 | 26
Phoenix 4MR 3.81 | phonix 4pin right 3.81 | 0 | 0 | 1 | 0 | 0 | 0 | 0 | 1 | 225630 | 225630 | ickala (https://www.ickala.com/phonix-381-right/20704-phoenix-4pin-right-381mm.html) | 28 | -27
Phoenix 8MR 3.81 | phonix 8pin right 3.81 | 0 | 0 | 2 | 0 | 0 | 0 | 0 | 2 | 36858 | 73716 | sedra (https://sedra.ir/%D8%AA%D8%B1%D9%85%DB%8C%D9%86%D8%A7%D9%84-%D9%81%D9%88%D9%86%DB%8C%DA%A9%D8%B3-PTR-%D8%B1%D8%A7%DB%8C%D8%AA-3.81-%D9%85%DB%8C%D9%84%DB%8C%D9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) | 24 | -22
Pin Header Female 1x6 | Female 6x1 | 0 | 0 | 0 | 0 | 0 | 0 | 0 | 0 | 47960 | 0 | ickala (https://ickala.com/pinheader-parts/3811-pin-header-female-140.html) | 0 | 0
Pin Header Male 1x6 19mm | HEADER 6X1 | 0 | 0 | 0 | 0 | 0 | 0 | 0 | 0 | 63000 | 0 | ickala (https://ickala.com/pinheader-parts/26228-pin-header-male-19m-140.html) | 2 | -2
Pin Header Male Right 1x4 | Header 1x4 male rightangle | 0 | 0 | 1 | 0 | 0 | 0 | 0 | 1 | 28231 | 28231 | ickala (https://www.ickala.com/pinheader-parts/12905-pin-header-male-140-right.html) | 16 | -15
Power Jack | Power Jack | 0 | 0 | 0 | 0 | 0 | 0 | 0 | 0 | 22500 | 0 | javan (http://www.javanelec.com/Shops/ProductDetail/1726?part_number=DC%20PLUG%205.5MM%20PCB) | 2 | -2
Power Source 24V 2A |  | 0 | 0 | 0 | 0 | 0 | 0 | 0 | 0 | 1000000 | 0 | gate (https://s16.picofile.com/file/8425630784/Gate_Electronic.jpg) | 2 | -2
Push Button | TE FSMSMTR | 0 | 0 | 1 | 0 | 0 | 0 | 0 | 1 | 28340 | 28340 | ickala (https://www.ickala.com/micro-switch/18903-tactile-switch-2ps-6-37-25.html) | 6 | -5
Quectel UC15 | Quectel UC15 | 0 | 0 | 0 | 0 | 0 | 0 | 0 | 0 | 13480000 | 0 | sisoog (https://sisoog.com/product/%D9%85%D8%A7%DA%98%D9%88%D9%84-uc15/) | 0 | 0
Rasberry FAN |  | 0 | 0 | 0 | 0 | 0 | 0 | 0 | 0 |  | 0 |  |  | 0
Rasberry Pi4 2GB RAM |  | 0 | 0 | 0 | 0 | 0 | 0 | 0 | 0 |  | 0 |  |  | 0
Reg AMS1117-3.3 | SOT223 | 0 | 0 | 1 | 0 | 0 | 0 | 0 | 1 | 31610 | 31610 | ickala (https://www.ickala.com/linear-regulators/9447-ams1117-33.html) | 16 | -15
Reg L7805 | D2PAK-3 | 0 | 0 | 1 | 0 | 0 | 0 | 0 | 1 | 130000 | 130000 | javan (https://www.javanelec.com/Shops/ProductDetail/10813) | 16 | -15
Reg LM2576-Adj | TO-263-5 | 0 | 0 | 0 | 0 | 0 | 0 | 0 | 0 | 709000 | 0 | javan (https://www.javanelec.com/Shops/ProductDetail/31699) | 16 | -16
Reg LM2576-5V | TO-263-5 | 0 | 0 | 0 | 0 | 0 | 0 | 0 | 0 | 71900 | 0 | javan (https://www.javanelec.com/Shops/ProductDetail/12568) |  | 0
Reg LM2576-12V | TO-263-5 | 0 | 0 | 0 | 0 | 0 | 0 | 0 | 0 | 170000 | 0 | paya (https://payaelectronic.ir/) |  | 0
Relay 5V 7A | Relay 20x16x20 HJR | 0 | 0 | 1 | 0 | 0 | 0 | 0 | 1 | 161000 | 161000 | javan (http://www.javanelec.com/Shops/ProductDetail/11538?part_number=RELAY%205V%207A%201C%205PIN) | 0 | 1
Res 1.5K(603) | RES 0603 (1608X06L) | 0 | 0 | 1 | 0 | 0 | 0 | 0 | 1 | 654 | 654 | ickala (https://www.ickala.com/r0603-1/14364-r15k-0603-1.html) | 16 | -15
Res 1.5K(805) | RES 0805 (2012X06L) | 0 | 0 | 0 | 0 | 0 | 0 | 0 | 0 | 467 | 0 | javan (http://www.javanelec.com/Shops/ProductDetail/3970?part_number=1.5K%20%280805%29) | 0 | 0
Res 100K(603) | RES 0603 (1608X06L) | 0 | 0 | 24 | 0 | 0 | 0 | 0 | 24 | 300 | 7200 | javan (https://www.javanelec.com/Shops/ProductDetail/3962) | 200 | -176
Res 100K(1206) | RES 1206 (3216X08L) | 0 | 0 | 0 | 0 | 0 | 0 | 0 | 0 | 700 | 0 | ickala (https://www.ickala.com/r1206-5/13302-r100k-1206-5.html) |  | 0
Res 10K(1206) | RES 1206 (3216X08L) | 0 | 0 | 0 | 0 | 0 | 0 | 0 | 0 | 1040 | 0 | javan (http://www.javanelec.com/Shops/ProductDetail/4081?part_number=10K%20%281206%29%201%25) | 0 | 0
Res 10K(603) | RES 0603 (1608X06L) | 0 | 0 | 14 | 0 | 0 | 0 | 0 | 14 | 354 | 4956 | javan (https://www.javanelec.com/Shops/ProductDetail/3963) | 0 | 14
Res 10K(805) | RES 0805 (2012X06L) | 0 | 0 | 24 | 0 | 0 | 0 | 0 | 24 | 550 | 13200 | javan (https://www.javanelec.com/Shops/ProductDetail/3978) | 200 | -176
Res 150R(1206) | RES 1206 (3216X08L) | 0 | 0 | 1 | 0 | 0 | 0 | 0 | 1 | 720 | 720 | javan (http://www.javanelec.com/Shops/ProductDetail/4087?part_number=150%20%281206%29) | 18 | -17
Res 15K(1206) | RES 1206 (3216X08L) | 0 | 0 | 0 | 0 | 0 | 0 | 0 | 0 | 720 | 0 | javan (http://www.javanelec.com/Shops/ProductDetail/4089?part_number=15K%20%281206%29) | 0 | 0
Res 180K(1206) | RES 1206 (3216X08L) | 0 | 0 | 1 | 0 | 0 | 0 | 0 | 1 | 720 | 720 | javan (http://www.javanelec.com/Shops/ProductDetail/4094?part_number=180K%20%281206%29) | 4 | -3
Res 1K(1206) | RES 1206 (3216X08L) | 0 | 0 | 24 | 0 | 0 | 0 | 0 | 24 | 631 | 15144 | javan (http://www.javanelec.com/Shops/ProductDetail/4096?part_number=1K%20%281206%29) | 120 | -96
Res 1K(603) | RES 0603 (1608X06L) | 0 | 0 | 1 | 0 | 0 | 0 | 0 | 1 | 330 | 330 | javan (http://www.javanelec.com/Shops/ProductDetail/4930?part_number=1K%20%280603%29) | 112 | -111
Res 1K(805) | RES 0805 (2012X06L) | 0 | 0 | 0 | 0 | 0 | 0 | 0 | 0 | 650 | 0 | ickala (https://www.ickala.com/r0805-1/14047-r1k-0805-1.html) | 16 | -16
Res 3.6K(1206) | RES 1206 (3216X08L) | 0 | 0 | 16 | 0 | 0 | 0 | 0 | 16 | 345 | 5520 | ickala (https://www.ickala.com/r1206-1/13155-r36k-1206-1.html) | 0 | 16
Res 20K(603) | RES 0603 (1608X06L) | 0 | 0 | 17 | 0 | 0 | 0 | 0 | 17 | 292 | 4964 | javan (https://www.javanelec.com/Shops/ProductDetail/20998) | 52 | -35
Res 20R(1206) | RES 1206 (3216X08L) | 0 | 0 | 0 | 0 | 0 | 0 | 0 | 0 | 1000 | 0 | ickala (https://www.ickala.com/r1206-1/13100-r20-1206-1.html) |  | 0
Res 20R(603) | RES 0603 (1608X06L) | 0 | 0 | 4 | 0 | 0 | 0 | 0 | 4 | 578 | 2312 | ickala (https://ickala.com/r0603-1/14408-r20-0603-1.html) | 84 | -80
Res 20R(1206) | RES 1206 (3216X08L) | 0 | 0 | 0 | 0 | 0 | 0 | 0 | 0 | 578 | 0 | ickala (https://ickala.com/r0603-1/14408-r20-0603-1.html) | 95 | -95
Res 2K(603) | RES 0603 (1608X06L) | 0 | 0 | 0 | 0 | 0 | 0 | 0 | 0 | 333 | 0 | javan (http://www.javanelec.com/Shops/ProductDetail/34950?part_number=2K%20%280603%29) | 2 | -2
Res 3.6K(805) | RES 0805 (2012X06L) | 0 | 0 | 0 | 0 | 0 | 0 | 0 | 0 | 800 | 0 | ickala (https://www.ickala.com/r0805-1/14129-r36k-0805-1.html) | 0 | 0
Res 390R(603) | RES 0603 (1608X06L) | 0 | 0 | 1 | 0 | 0 | 0 | 0 | 1 | 333 | 333 | javan (https://www.javanelec.com/Shops/ProductDetail/33821) | 16 | -15
Res 4.7K(603) | RES 0603 (1608X06L) | 0 | 0 | 0 | 0 | 0 | 0 | 0 | 0 | 365 | 0 | javan (http://www.javanelec.com/Shops/ProductDetail/20990?part_number=4.7K%20%280603%29%201%25) | 10 | -10
Res 470R(603) | RES 0603 (1608X06L) | 0 | 0 | 0 | 0 | 0 | 0 | 0 | 0 | 333 | 0 | javan (http://www.javanelec.com/Shops/ProductDetail/33825?part_number=470%20%280603%29) | 0 | 0
Res 47K(603) | RES 0603 (1608X06L) | 0 | 0 | 0 | 0 | 0 | 0 | 0 | 0 | 333 | 0 | javan (http://www.javanelec.com/Shops/ProductDetail/9300?part_number=47K%20%280603%29) | 4 | -4
Res 4.7K(805) | RES 0805 (2012X06L) | 0 | 0 | 0 | 0 | 0 | 0 | 0 | 0 | 847 | 0 | javan (https://www.javanelec.com/Shops/ProductDetail/4036) | 16 | -16
Res 560R(603) | RES 0603 (1608X06L) | 0 | 0 | 4 | 0 | 0 | 0 | 0 | 4 | 333 | 1332 | javan (http://www.javanelec.com/Shops/ProductDetail/2508?part_number=560%20%280603%29) | 48 | -44
Res 5K(1206) | RES 1206 (3216X08L) | 0 | 0 | 16 | 0 | 0 | 0 | 0 | 16 | 800 | 12800 | javan (https://www.javanelec.com/Shops/ProductDetail/4133) | 160 | -144
Res 5K(603) | RES 0603 (1608X06L) | 0 | 0 | 25 | 0 | 0 | 0 | 0 | 25 | 540 | 13500 | ickala (https://www.ickala.com/r0603-5/14605-r51k-0603-5.html) | 0 | 25
Res 5.6K(0805) | RES 0805 (2012X06L) | 0 | 0 | 0 | 0 | 0 | 0 | 0 | 0 | 800 | 0 | javan (https://www.javanelec.com/Shops/ProductDetail/4133) | 10 | -10
Res 680R(603) | RES 0603 (1608X06L) | 0 | 0 | 0 | 0 | 0 | 0 | 0 | 0 | 333 | 0 | javan (http://www.javanelec.com/Shops/ProductDetail/9299?part_number=680%20%280603%29) | 0 | 0
RFID RC522 Module |  | 0 | 0 | 0 | 0 | 0 | 0 | 0 | 0 | 475000 | 0 | amjadkala (https://amjadkala.com/product/rc522/) |  | 0
RJ45 FMR | RJ45 Female Right | 0 | 0 | 1 | 0 | 0 | 0 | 75 | 76 | 84500 | 6422000 | javan (http://www.javanelec.com/Shops/ProductDetail/2003?part_number=DY122-8P8C-G) | 0 | 76
SMA Antena |  | 0 | 0 | 0 | 0 | 0 | 0 | 0 | 0 | 235000 | 0 | javan (https://www.javanelec.com/Shops/ProductDetail/27861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) | 0 | 0
SMA FMR | MOLEX SD-73100-0114 | 0 | 0 | 0 | 0 | 0 | 0 | 0 | 0 | 436000 | 0 | ickala (https://www.ickala.com/onboard-connector-sma/23362-sma-%D8%B1%D9%88%D8%A8%D8%B1%D8%AF%DB%8C.html) | 0 | 0
Socket_SIM_MEM | microsd&SimCardSocket | 0 | 0 | 0 | 0 | 0 | 0 | 0 | 0 | 477420 | 0 | ickala (https://www.ickala.com/memmory-holder/15799-sim-memory-small.html) | 0 | 0
SD Card(16GB) |  | 0 | 0 | 0 | 0 | 0 | 0 | 0 | 0 |  | 0 |  |  | 0
SW DIP-2 | DIP Switch x2 | 0 | 0 | 0 | 0 | 0 | 0 | 0 | 0 | 19200 | 0 | javan (https://www.javanelec.com/Shops/ProductDetail/6989?part_number=DS1040-02RN) |  | 0
SW DIP-4 | DIP Switch x4 | 0 | 0 | 1 | 0 | 0 | 0 | 0 | 1 | 32600 | 32600 | javan (https://www.javanelec.com/Shops/ProductDetail/6991?part_number=DS1040-04RN&part_number=DS1040-04RN) | 0 | 1
SW DIP-6 | DIP Switch x6 | 0 | 0 | 0 | 0 | 0 | 0 | 0 | 0 | 39200 | 0 | javan (https://www.javanelec.com/Shops/ProductDetail/6994) |  | 0
SW DIP-6 | DIP Switch x6 | 0 | 0 | 0 | 0 | 0 | 0 | 0 | 0 | 32600 | 0 | javan (https://www.javanelec.com/Shops/ProductDetail/6994?part_number=DS1040-06RN) | 0 | 0
SW DIP-2 | DIP Switch x2 | 0 | 0 | 0 | 0 | 0 | 0 | 0 | 0 | 32600 | 0 | javan (https://www.javanelec.com/Shops/ProductDetail/6989?part_number=DS1040-02RN) | 0 | 0
SW DPDT | Switch - SPDT 15.5 | 0 | 0 | 0 | 0 | 0 | 0 | 0 | 0 | 25500 | 0 | javan (http://www.javanelec.com/Shops/ProductDetail/3025?part_number=SS-22F25G5) | 0 | 0
Tr BC848 | SOT23-3 | 0 | 0 | 24 | 0 | 0 | 0 | 0 | 24 | 3270 | 78480 | ickala (https://www.ickala.com/bjt-parts/12142-bc848b.html?search_query=bc848&results=2) | 0 | 24
Tr BSS138 | SOT23-3 | 0 | 0 | 24 | 0 | 0 | 0 | 0 | 24 | 17985 | 431640 | ickala (https://www.ickala.com/mosfet-parts/19368-bss138.html) | 0 | 24
USB Micro | FCI USB 10118193-0001LF | 0 | 0 | 1 | 0 | 0 | 0 | 0 | 1 |  | 0 | ickala (https://www.ickala.com/usb-onboard/22230-usb-smt-onboard.html) | 16 | -15
Var 07D471K | or 07D431K or 07D391K | 0 | 0 | 2 | 0 | 0 | 0 | 0 | 2 | 8450 | 16900 | javan (https://www.javanelec.com/Shops/ProductDetail/6578) | 41 | -39
XH 4FMR | Wired | 0 | 0 | 1 | 0 | 0 | 0 | 0 | 1 | 83040 | 83040 | sedra (https://sedra.ir/%DA%A9%D8%A7%D9%86%DA%A9%D8%AA%D9%88%D8%B1-%D8%B3%DB%8C%D9%85%20%D8%AF%D8%A7%D8%B1-XH-%D8%A7%DB%8C%DA%A9%D8%B3-%D8%A7%DA%86-4-%D9%BE%DB%8C%D9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) | 0 | 1
XH 4MR | CN_JST-B4B-S_XH | 0 | 0 | 1 | 0 | 0 | 0 | 0 | 1 | 8393 | 8393 | ickala (https://ickala.com/%DA%A9%D8%A7%D9%86%DA%A9%D8%AA%D9%88%D8%B1%D9%86%D8%B1%DB%8C-xh-%D8%B1%D8%A7%DB%8C%D8%AA/26255-xh-4p-r-m.html) | 4 | -3
XH 8FMR | Wired | 0 | 0 | 0 | 0 | 0 | 0 | 0 | 0 | 74890 | 0 | sedra (https://sedra.ir/%DA%A9%D8%A7%D9%86%DA%A9%D8%AA%D9%88%D8%B1-%D8%B3%DB%8C%D9%85%20%D8%AF%D8%A7%D8%B1-XH-%D8%A7%DB%8C%DA%A9%D8%B3-%D8%A7%DA%86-8-%D9%BE%DB%8C%D9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) |  | 0
XH 8MR | CN_JST-B8B-S_XH | 0 | 0 | 0 | 0 | 0 | 0 | 0 | 0 | 7957 | 0 | ickala (https://ickala.com/%DA%A9%D8%A7%D9%86%DA%A9%D8%AA%D9%88%D8%B1%D9%86%D8%B1%DB%8C-xh-%D8%B1%D8%A7%DB%8C%D8%AA/26721-xh-8p-r-m.html) |  | 0
XH 5FMR | Wired | 0 | 0 | 0 | 0 | 0 | 0 | 0 | 0 | 83040 | 0 | sedra (https://sedra.ir/%DA%A9%D8%A7%D9%86%DA%A9%D8%AA%D9%88%D8%B1-%D8%B3%DB%8C%D9%85%20%D8%AF%D8%A7%D8%B1-XH-%D8%A7%DB%8C%DA%A9%D8%B3-%D8%A7%DA%86-4-%D9%BE%DB%8C%D9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) | 0 | 0
XH 5MR | CN_JST-B5B-S_XH | 0 | 0 | 0 | 0 | 0 | 0 | 0 | 0 | 8393 | 0 | ickala (https://ickala.com/%DA%A9%D8%A7%D9%86%DA%A9%D8%AA%D9%88%D8%B1%D9%86%D8%B1%DB%8C-xh-%D8%B1%D8%A7%DB%8C%D8%AA/26255-xh-4p-r-m.html) | 0 | 0
XH 8FMR | Wired | 0 | 0 | 0 | 0 | 0 | 0 | 0 | 0 | 83040 | 0 | sedra (https://sedra.ir/%DA%A9%D8%A7%D9%86%DA%A9%D8%AA%D9%88%D8%B1-%D8%B3%DB%8C%D9%85%20%D8%AF%D8%A7%D8%B1-XH-%D8%A7%DB%8C%DA%A9%D8%B3-%D8%A7%DA%86-4-%D9%BE%DB%8C%D9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) | 0 | 0
XH 8MR | CN_JST-B5B-S_XH | 0 | 0 | 0 | 0 | 0 | 0 | 0 | 0 | 8393 | 0 | ickala (https://ickala.com/%DA%A9%D8%A7%D9%86%DA%A9%D8%AA%D9%88%D8%B1%D9%86%D8%B1%DB%8C-xh-%D8%B1%D8%A7%DB%8C%D8%AA/26255-xh-4p-r-m.html) | 0 | 0
XTAL 32.768KHz | XTAL RTC - Right | 0 | 0 | 1 | 0 | 0 | 0 | 0 | 1 | 30847 | 30847 | ickala (https://www.ickala.com/crystal-quartz-dip/17461-crystal-32768kmhz-large.html) | 16 | -15
XTAL 8MHz | Crystal SMD | 0 | 0 | 1 | 0 | 0 | 0 | 0 | 1 | 43600 | 43600 | ickala (https://www.ickala.com/crystal-quartz-smd/17372-crystal-8000mhz-smd.html?search_query=Crystal+SMD&results=21) | 16 | -15
Print Board MBS V1.0 |  | 0 | 0 | 0 | 0 | 1 | 0 | 0 | 1 | 500000 | 500000 |  | 0 | 1
Assemble Board MBS V1.0 |  | 0 | 0 | 0 | 0 | 1 | 0 | 0 | 1 | 1200000 | 1200000 |  | 0 | 1
Print Board MOBS V1.0 |  | 0 | 0 | 0 | 0 | 0 | 1 | 0 | 1 | 500000 | 500000 |  | 0 | 1
Assemble Board MOBS V1.0 |  | 0 | 0 | 0 | 0 | 0 | 1 | 0 | 1 | 1200000 | 1200000 |  | 0 | 1
Print Board EBS V3.0 |  | 0 | 0 | 0 | 0 | 0 | 0 | 0 | 0 | 500000 | 0 |  | 0 | 0
Assemble Board EBS V3.0 |  | 0 | 0 | 0 | 0 | 0 | 0 | 0 | 0 | 1200000 | 0 |  | 0 | 0
Print Board EBS V1.0 |  | 0 | 0 | 0 | 0 | 0 | 0 | 0 | 0 | 500000 | 0 |  | 0 | 0
Assemble Board EBS V1.0 |  | 0 | 0 | 0 | 0 | 0 | 0 | 0 | 0 | 1200000 | 0 |  | 0 | 0
Print Board HBS V2.0 |  | 0 | 0 | 0 | 0 | 0 | 0 | 0 | 0 | 500000 | 0 |  | 0 | 0
Assemble Board HBS V2.0 |  | 0 | 0 | 0 | 0 | 0 | 0 | 0 | 0 | 1200000 | 0 |  | 0 | 0
Print Board HBS V1.0 |  | 0 | 0 | 0 | 0 | 0 | 0 | 0 | 0 | 500000 | 0 |  | 0 | 0
Assemble Board HBS V1.0 |  | 0 | 0 | 0 | 0 | 0 | 0 | 0 | 0 | 1200000 | 0 |  | 0 | 0
 |  |  |  |  |  |  |  |  |  |  | 16734652

Sheet: اطلاعات پروژه
اطلاعات پروژه
عنوان | تعداد | نوع
EBS V1.0 | 1
EBS V2.0 | 0
EBS V3.0 | 0
HBS V1.0 | 0
HBS V2.0 | 0
HBS V3.0 | 0
MBS V1.0 | 0
MBS V2.0 | 0
MOBS V1.0 | 0
MOBS V2.0 | 0
تعداد طبقات | 25
تعداد پنل مکانیکی | 0 | AKM
تعداد پنل تاچ | 0 | AFT

Sheet: هزینه‌های پروژه
پاور و سیم مازاد |  |  | قیمت های فروش
هر متر زوج‌سیم | کابل LAN | پاور 24V 15A | ایاب و ذهاب | ثابت پروژه | پنل | EBS | HBS
50000 | 500000 | 8500000 | 20000000 | 1200000000 | 120000000 | 60000000 | 70000000

Sheet: برایند هزینه پروژه
عنوان | مبلغ(ریال)
هزینه بردها | 16734652
ثابت پروژه | 1200000000
هزینه سیم | 12500000
هزینه پاور | 0
هزینه کابل LAN | 12500000
قیمت پنل‌ها | 0
قیمت برد EBS | 60000000
قیمت برد HBS | 0
ایاب و ذهاب | 20000000
قیمت فروش | 1305000000
سود پروژه | 1288265348
