hosseinszza/Sidex-release/(list of files, drawings)

Other design files:
Hardware/V1.0/Hub RJ45/PCB.PcbDoc
Hardware/V1.0/TouchPanel/TouchPanel.PcbDoc
